wjohnsaunders/VoronMods/README.md

# VoronMods
Modified parts for my Voron Trident
