wjohnsaunders/VoronMods/Trident_InletSkirt_Ender3/README.md

# Trident Skirt Inlet for Ender3 style switch

This inlet fits switched and fused main inlets that is fitted to the
Ender3 and is common on many other 3D printers from China.

# Printing and Installed

Consult for Voron Trident manual, it is much the same as the stock one.
