wjohnsaunders/VoronMods/Trident_InletSkirt_SchurterDD12/README.md

# Schurter DD12 Inlet

This is a remix of the Schurter Inlet found on Voron Mods. That one was too
tight and didn't fit the DD12 model that I bought. I just increased the
size of the cutout by a millimitre or so.

## Printing

Print as-is, outer side up.
