wjohnsaunders/VoronMods/BedFanMount5020Blower/CAD/BedFanMount5020Blower.FCStd

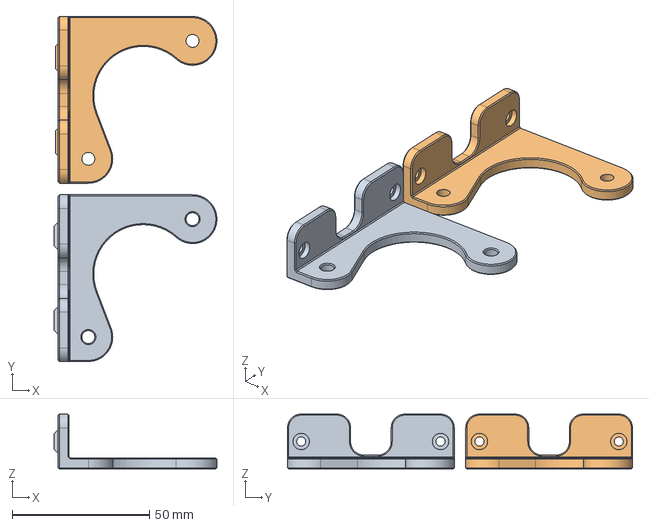
[picture p11: CAD file, 2026-07-20]
BedFanMount5020Blower/CAD/BedFanMount5020Blower.FCStd
59.4 x 125.8 x 20.0 mm
VSlot
Misumi
