wjohnsaunders/VoronMods/Fan_Hub_JST-XH/CAD/Fan_Hub_JST-XH.FCStd

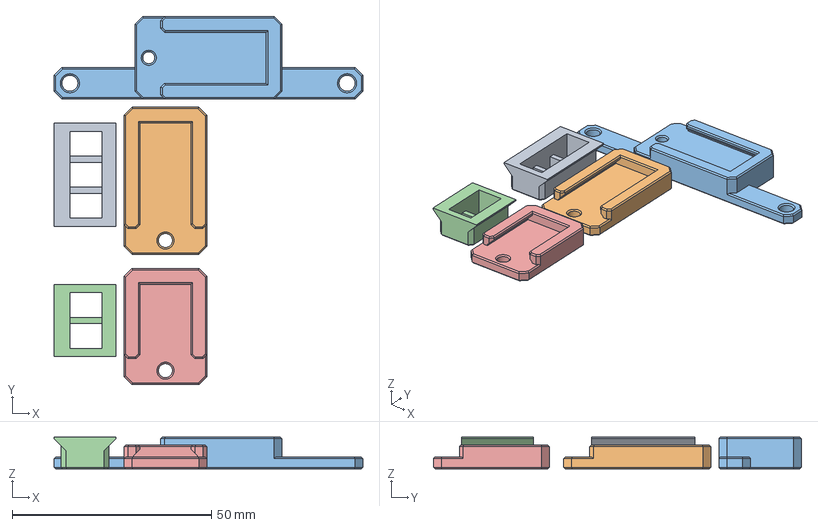
[picture p12: CAD file, 2026-07-20]
Fan_Hub_JST-XH/CAD/Fan_Hub_JST-XH.FCStd
77.6 x 92.5 x 8.00 mm
Holder-3way
BaseExtrusion-3way
BaseVoronFans-3way
Holder-2way
BaseExtrusion-2way
