wjohnsaunders/VoronMods/Fan_Hub_JST-XH/STL/Fan_Hub_JST-XH-BaseExtrusion-3way.stl

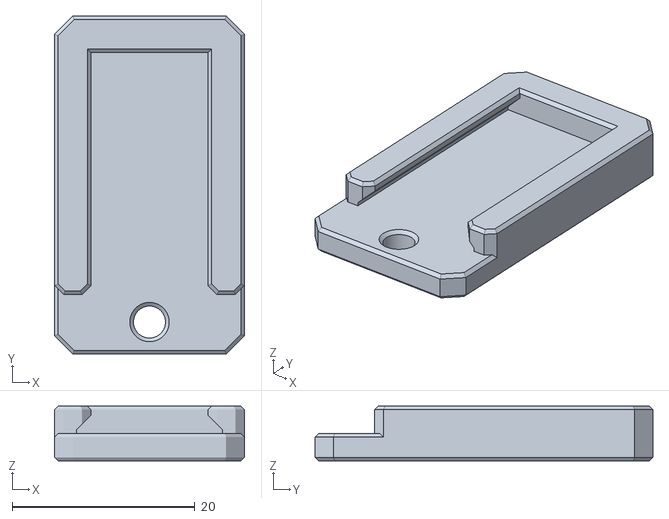
[picture p13: CAD file, 2026-07-20]
Fan_Hub_JST-XH/STL/Fan_Hub_JST-XH-BaseExtrusion-3way.stl
20.8 x 37.0 x 6.00
