wjohnsaunders/VoronMods/FumeExtraction/CAD/HoseAdapters-12.5mmHoseAdapter.step

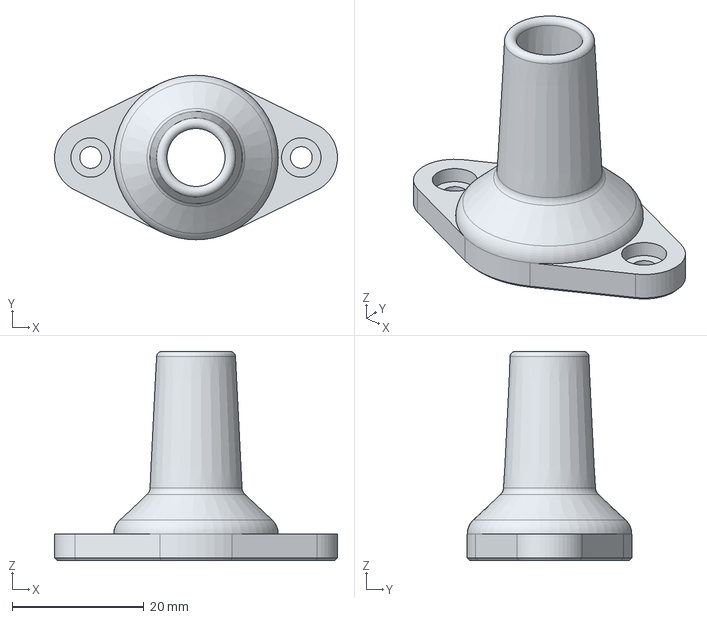
[picture p14: CAD file, 2026-07-13]
FumeExtraction/CAD/HoseAdapters-12.5mmHoseAdapter.step
43.0 x 25.0 x 31.8 mm
