wjohnsaunders/VoronMods/MGN12_Mods/MGN12_clickyclack_door/CAD/MGN12_Handle-Hinge_Top.FCStd

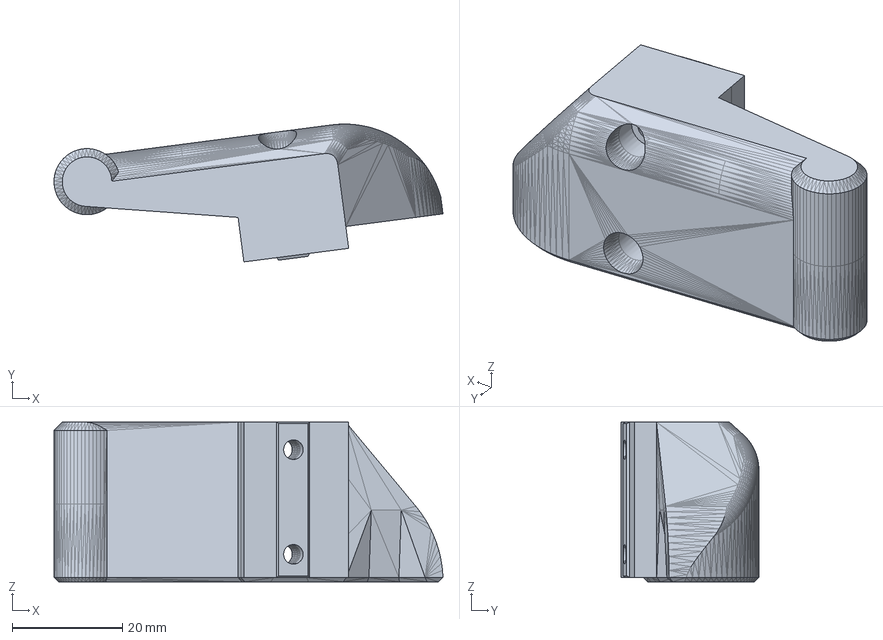
[picture p15: CAD file, 2026-07-13]
MGN12_Mods/MGN12_clickyclack_door/CAD/MGN12_Handle-Hinge_Top.FCStd
70.6 x 25.0 x 29.0 mm
