wjohnsaunders/VoronMods/MGN12_Mods/MGN12_y_endstop_housing/3MF/[a]_MGN12_y_endstop_housing.3mf

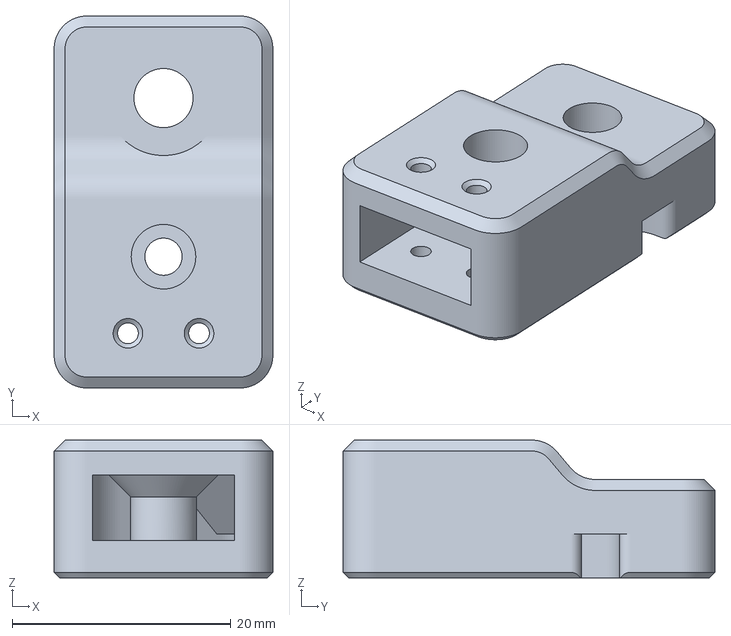
[picture p17: CAD file, 2025-08-18]
MGN12_Mods/MGN12_y_endstop_housing/3MF/[a]_MGN12_y_endstop_housing.3mf
20.0 x 34.0 x 12.6 mm
