wjohnsaunders/VoronMods/MGN12_Mods/MGN12_z_rail_stop/CAD/MGN12_z_rail_stop.FCStd

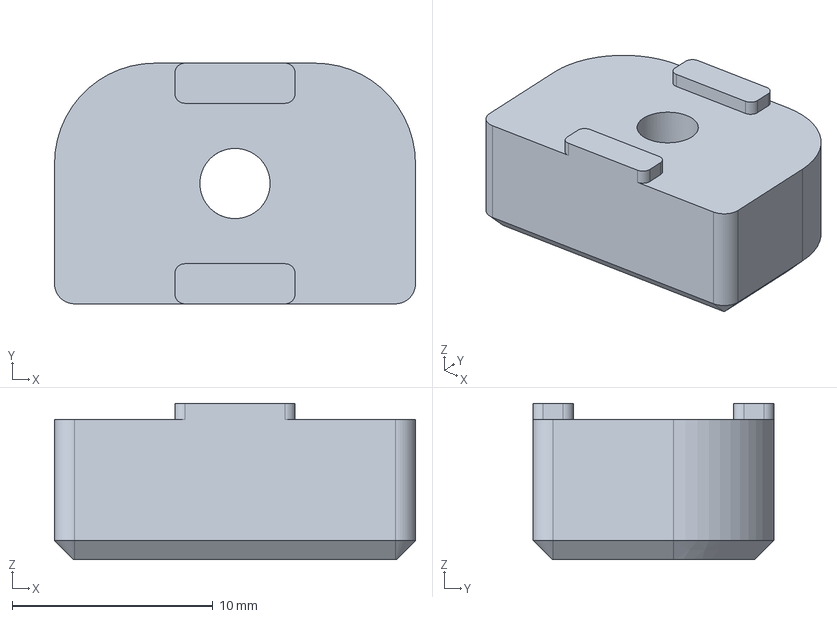
[picture p18: CAD file, 2025-08-18]
MGN12_Mods/MGN12_z_rail_stop/CAD/MGN12_z_rail_stop.FCStd
18.0 x 12.0 x 7.80 mm
