wjohnsaunders/VoronMods/Panel_Router_Templates/3MF/Deck_Panel_Router_Template-RearMotor.3mf

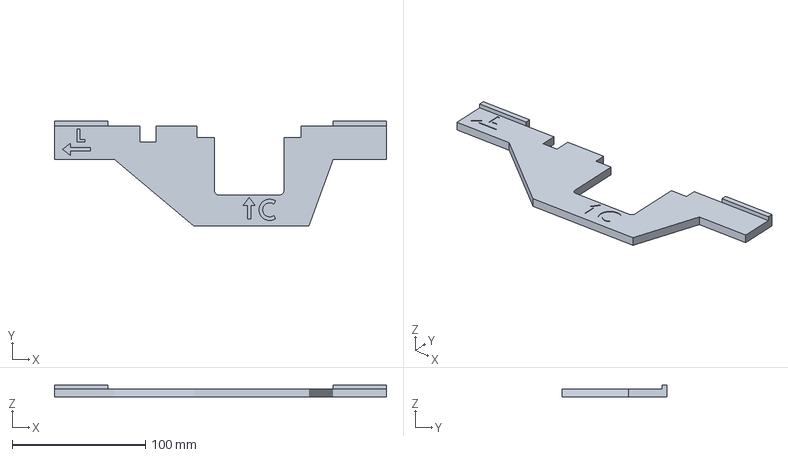
[picture p19: CAD file, 2025-08-18]
Panel_Router_Templates/3MF/Deck_Panel_Router_Template-RearMotor.3mf
249.0 x 79.0 x 9.00 mm
