wjohnsaunders/VoronMods/ThermistorExtrusionMount/CAD/ThermistorExtrusionMount.FCStd

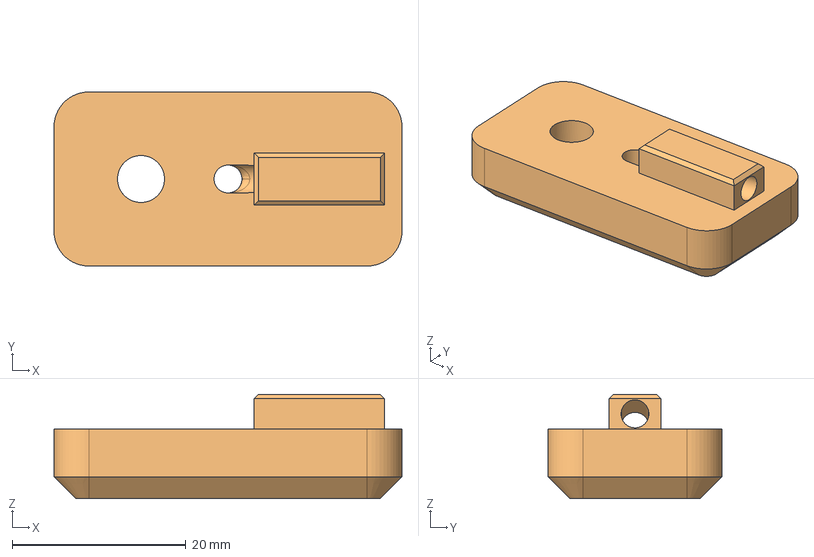
[picture p20: CAD file, 2026-07-13]
ThermistorExtrusionMount/CAD/ThermistorExtrusionMount.FCStd
40.0 x 20.0 x 12.0 mm
NoLogo
VoronLogoHorizontalMounted
VoronLogoVerticalMounted
