wjohnsaunders/VoronMods/Trident_InletSkirt_Ender3/CAD/TridentInletSkirt-Ender3.step

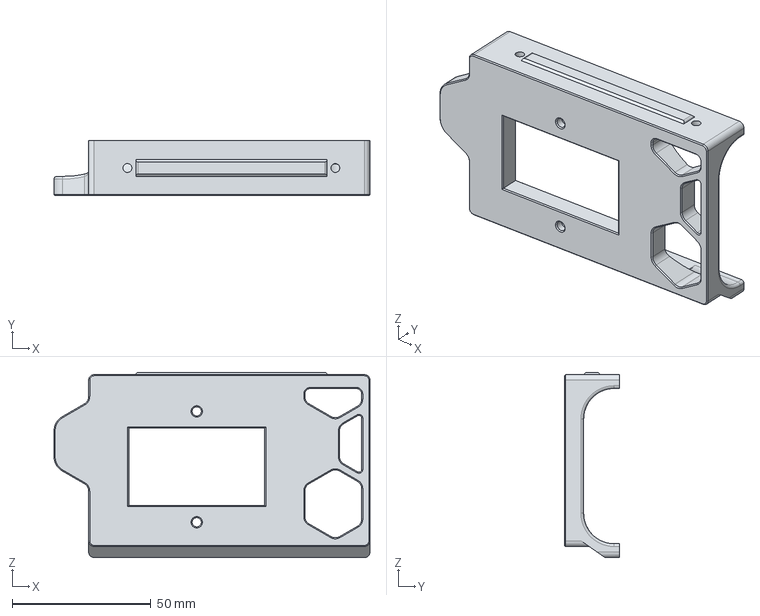
[picture p21: CAD file, 2026-07-13]
Trident_InletSkirt_Ender3/CAD/TridentInletSkirt-Ender3.step
114.0 x 20.0 x 66.8 mm
