wjohnsaunders/VoronMods/Trident_InletSkirt_SchurterDD12/CAD/Schurter_DD12_Inlet.FCStd

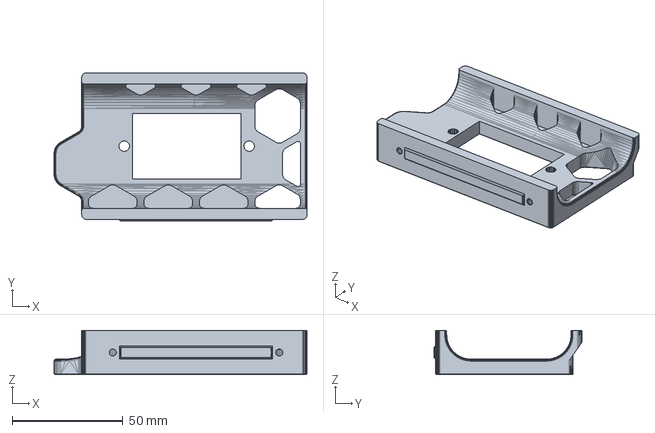
[picture p22: CAD file, 2025-08-18]
Trident_InletSkirt_SchurterDD12/CAD/Schurter_DD12_Inlet.FCStd
114.0 x 66.8 x 20.0 mm
