wjohnsaunders/VoronMods/Trident_R1_Mods/Coupler_z_stepper/CAD/z_stepper_small_rear.FCStd

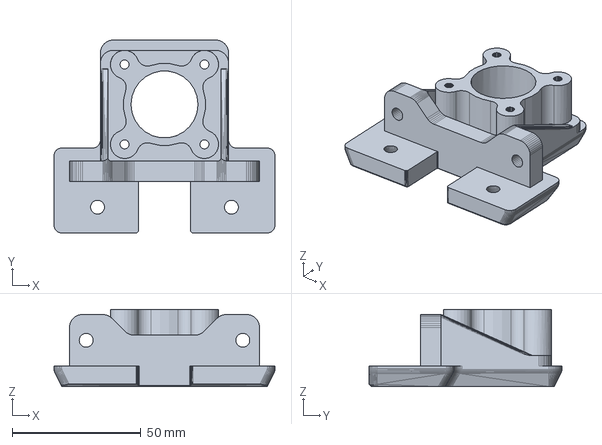
[picture p23: CAD file, 2025-10-06]
Trident_R1_Mods/Coupler_z_stepper/CAD/z_stepper_small_rear.FCStd
85.8 x 74.9 x 30.0 mm
