wjohnsaunders/VoronMods/Trident_R2_Mods/Coupler_z_stepper/CAD/R2_z_stepper.FCStd

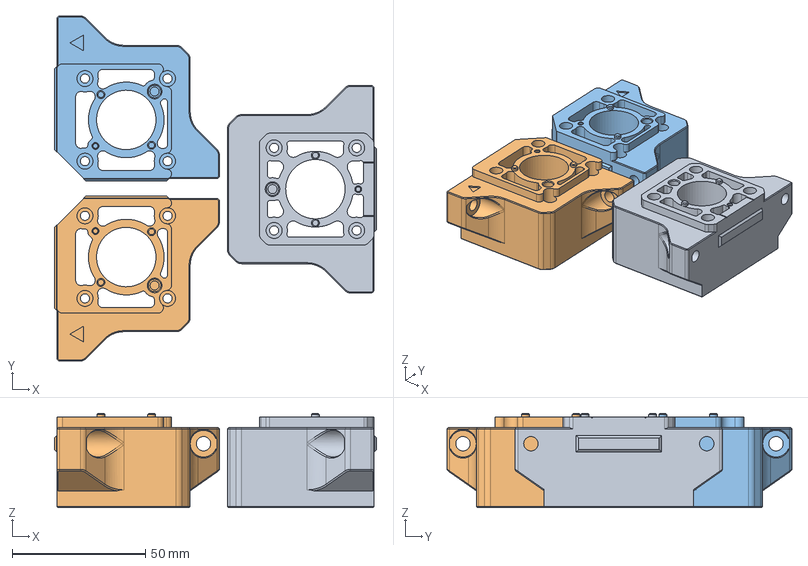
[picture p24: CAD file, 2026-07-13]
Trident_R2_Mods/Coupler_z_stepper/CAD/R2_z_stepper.FCStd
121.0 x 129.5 x 35.4 mm
rear_coupler
left_coupler
right_coupler
