wjohnsaunders/VoronMods/BedFanMount5020Blower/STL/BedFanMount5020Blower-VSlot.stl

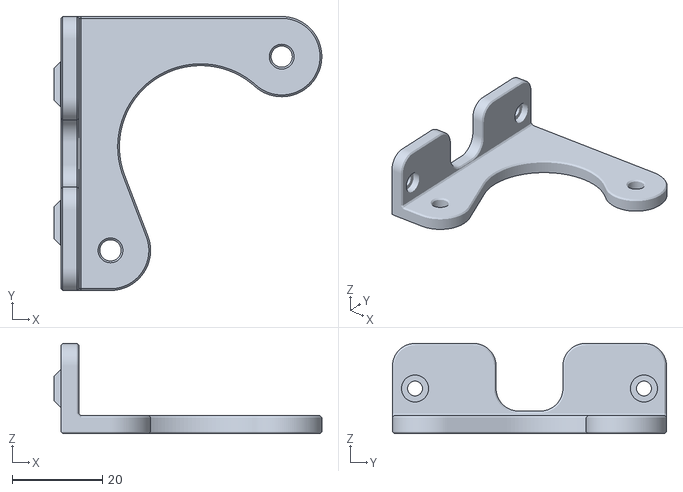
[picture p25: CAD file, 2026-07-20]
BedFanMount5020Blower/STL/BedFanMount5020Blower-VSlot.stl
59.4 x 60.8 x 20.0
