wjohnsaunders/VoronMods/Fan_Hub_JST-XH/STL/Fan_Hub_JST-XH-BaseExtrusion-2way.stl

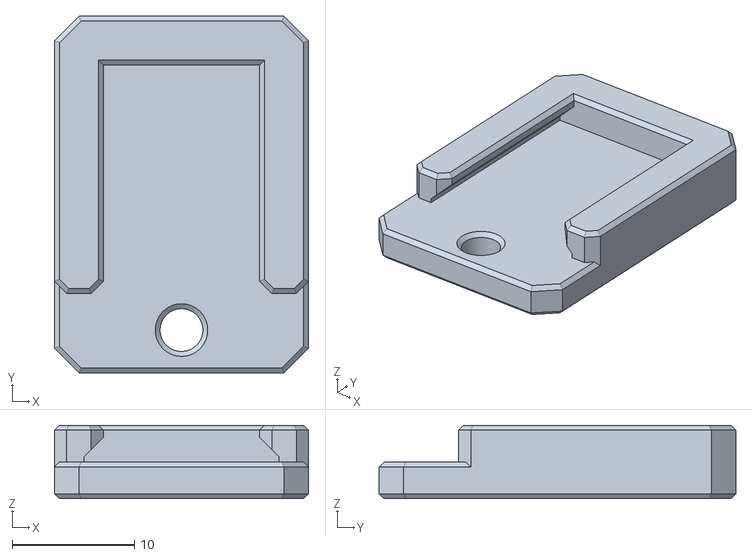
[picture p26: CAD file, 2026-07-20]
Fan_Hub_JST-XH/STL/Fan_Hub_JST-XH-BaseExtrusion-2way.stl
20.8 x 29.2 x 6.00
