wjohnsaunders/VoronMods/FumeExtraction/CAD/HoseAdapters-22mmISOTaperHoseAdapter.step

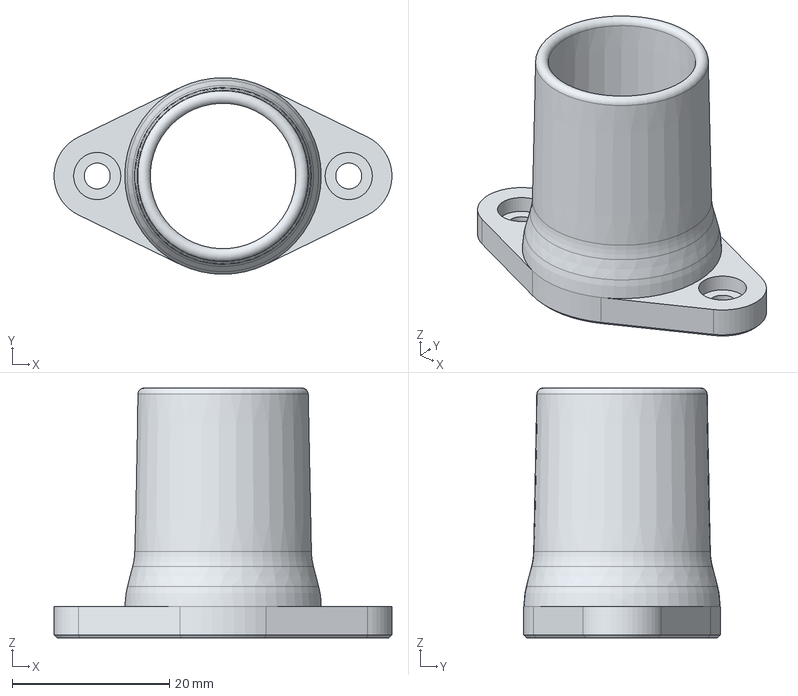
[picture p27: CAD file, 2026-07-13]
FumeExtraction/CAD/HoseAdapters-22mmISOTaperHoseAdapter.step
43.0 x 25.0 x 31.8 mm
