wjohnsaunders/VoronMods/MGN12_Mods/MGN12_clickyclack_door/CAD/MGN12_Handle-Hinge_Bottom.FCStd

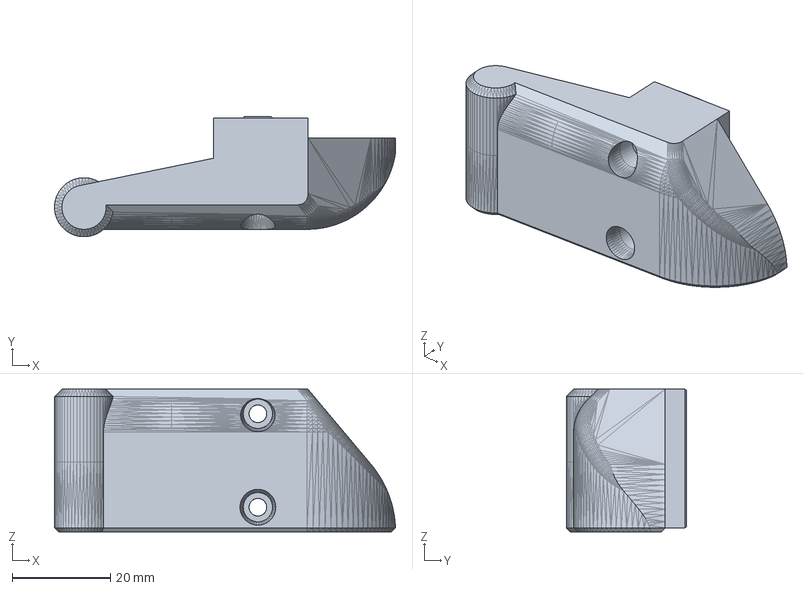
[picture p28: CAD file, 2025-08-18]
MGN12_Mods/MGN12_clickyclack_door/CAD/MGN12_Handle-Hinge_Bottom.FCStd
69.3 x 24.5 x 29.0 mm
