wjohnsaunders/VoronMods/MGN12_Mods/MGN12_panel_clips/CAD/corner_panel_clip_7p5mm.FCStd

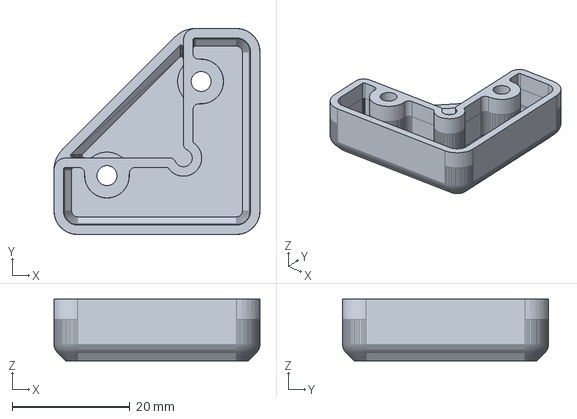
[picture p29: CAD file, 2026-07-13]
MGN12_Mods/MGN12_panel_clips/CAD/corner_panel_clip_7p5mm.FCStd
35.0 x 35.0 x 10.5 mm
