wjohnsaunders/VoronMods/Panel_Router_Templates/3MF/Deck_Panel_Router_Template-LeftRightMotor.3mf

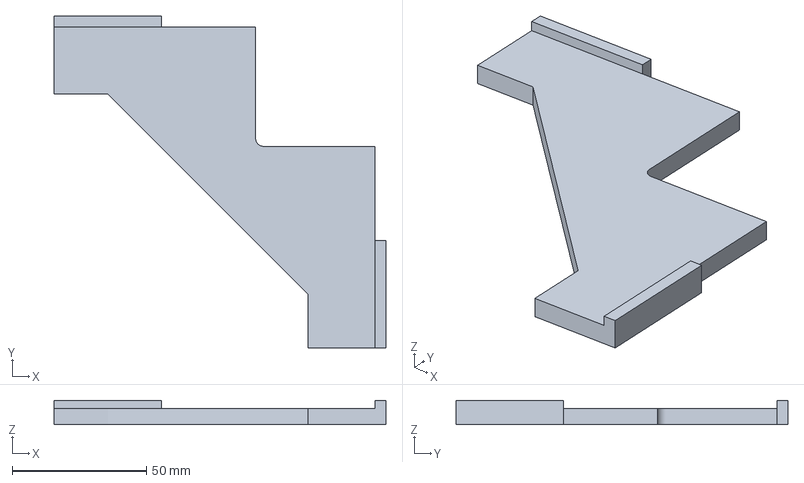
[picture p30: CAD file, 2025-08-18]
Panel_Router_Templates/3MF/Deck_Panel_Router_Template-LeftRightMotor.3mf
123.5 x 123.5 x 9.00 mm
