wjohnsaunders/VoronMods/Panel_Router_Templates/CAD/Rear_Panel_Router_Template.FCStd

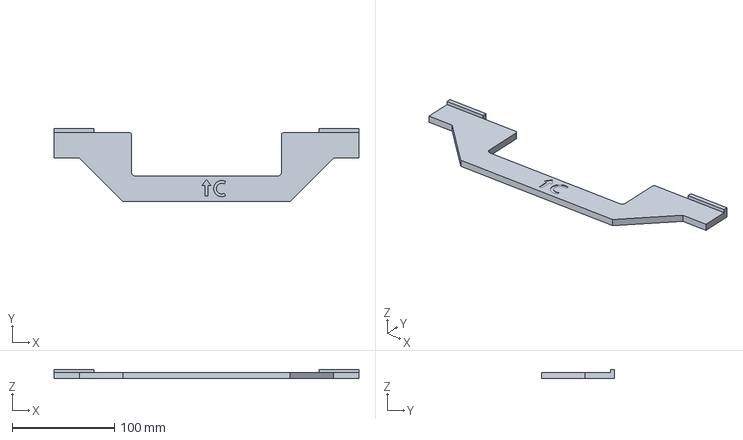
[picture p31: CAD file, 2025-08-18]
Panel_Router_Templates/CAD/Rear_Panel_Router_Template.FCStd
299.0 x 71.5 x 9.00 mm
