wjohnsaunders/VoronMods/ThermistorExtrusionMount/CAD/ThermistorExtrusionMount-VoronLogoHorizontalMounted.step

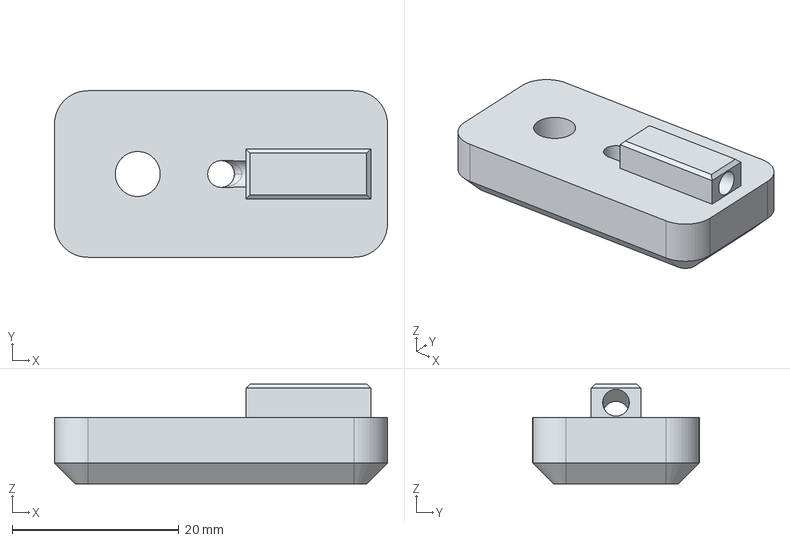
[picture p32: CAD file, 2026-07-13]
ThermistorExtrusionMount/CAD/ThermistorExtrusionMount-VoronLogoHorizontalMounted.step
40.0 x 20.0 x 12.0 mm
