wjohnsaunders/VoronMods/Trident_R1_Mods/Coupler_z_stepper/CAD/z_stepper_small_left.FCStd

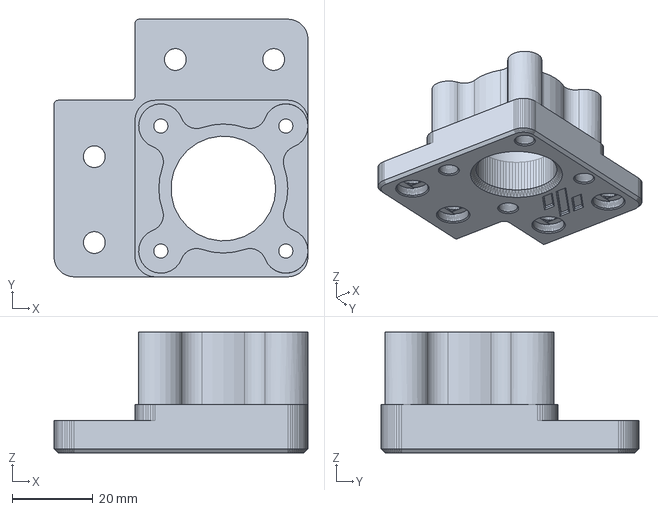
[picture p33: CAD file, 2025-10-06]
Trident_R1_Mods/Coupler_z_stepper/CAD/z_stepper_small_left.FCStd
63.0 x 63.9 x 30.0 mm
