wjohnsaunders/VoronMods/Trident_R2_Mods/Coupler_z_stepper/CAD/R2_z_stepper-rear_coupler.step

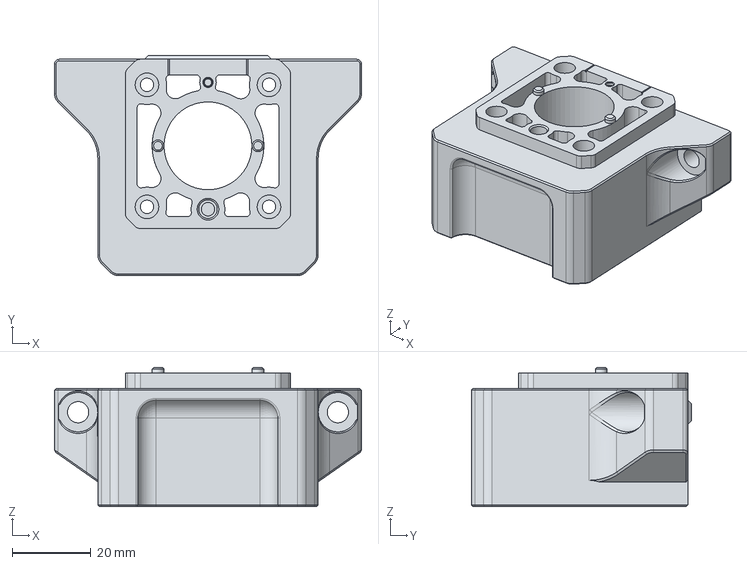
[picture p34: CAD file, 2026-07-13]
Trident_R2_Mods/Coupler_z_stepper/CAD/R2_z_stepper-rear_coupler.step
78.0 x 56.0 x 35.4 mm
