wjohnsaunders/VoronMods/Fan_Hub_JST-XH/STL/Fan_Hub_JST-XH-BaseVoronFans-3way.stl

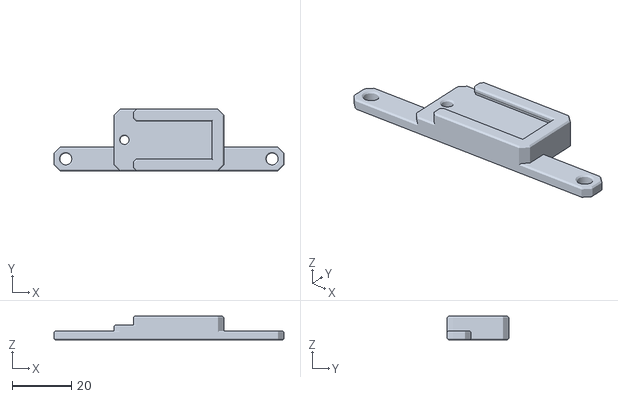
[picture p35: CAD file, 2026-07-20]
Fan_Hub_JST-XH/STL/Fan_Hub_JST-XH-BaseVoronFans-3way.stl
77.6 x 20.8 x 8.00
