wjohnsaunders/VoronMods/FumeExtraction/CAD/FumeExtraction.FCStd

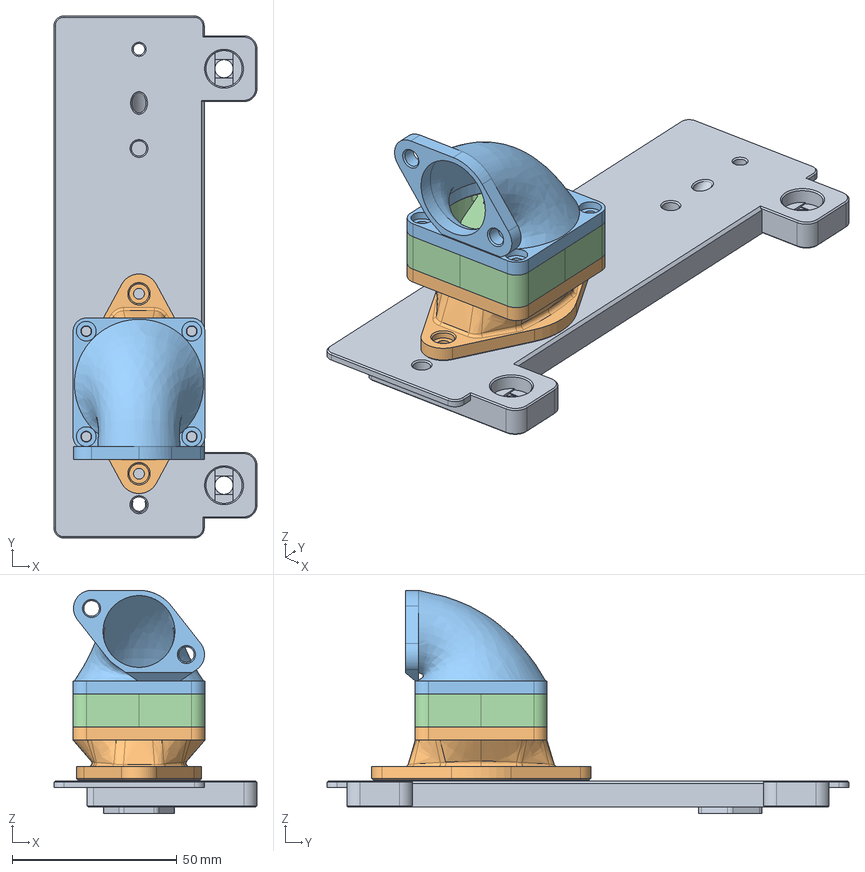
[picture p36: CAD file, 2026-07-13]
FumeExtraction/CAD/FumeExtraction.FCStd
61.6 x 158.4 x 67.8 mm
ExhaustCoverR2WithVent
ExhaustToFanAdapter
FanToHoseAdapter
40mm fan v2
40mm fan v001
