wjohnsaunders/VoronMods/MGN12_Mods/MGN12_clickyclack_door/CAD/MGN12_Latch.FCStd

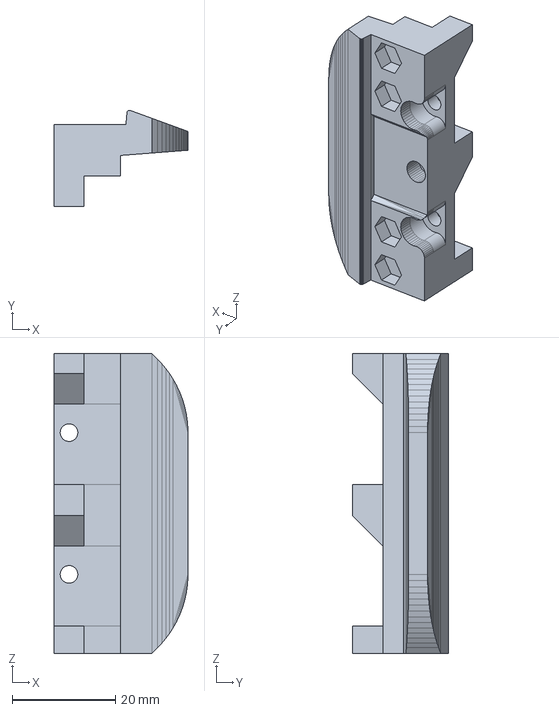
[picture p37: CAD file, 2025-08-18]
MGN12_Mods/MGN12_clickyclack_door/CAD/MGN12_Latch.FCStd
25.9 x 18.6 x 58.0 mm
