wjohnsaunders/VoronMods/MGN12_Mods/MGN12_panel_clips/CAD/midspan_panel_clip_7p5mm.FCStd

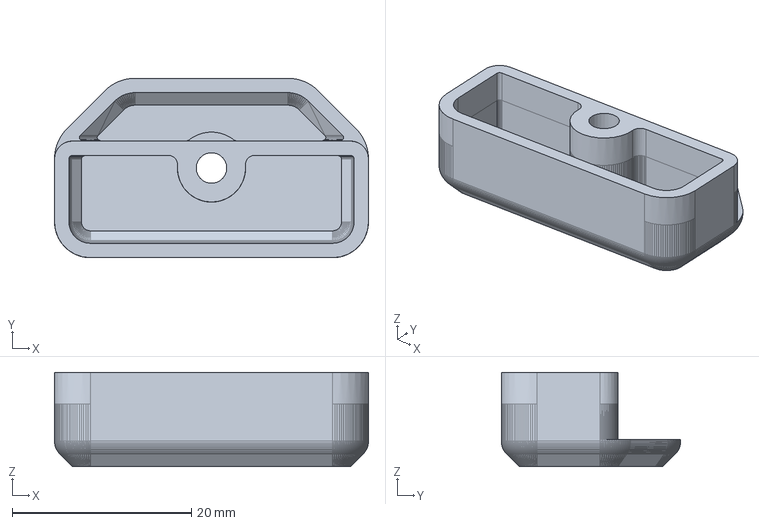
[picture p38: CAD file, 2026-07-13]
MGN12_Mods/MGN12_panel_clips/CAD/midspan_panel_clip_7p5mm.FCStd
35.0 x 20.0 x 10.5 mm
