wjohnsaunders/VoronMods/Panel_Router_Templates/3MF/Bottom_Panel_Router_Template-Corner.3mf

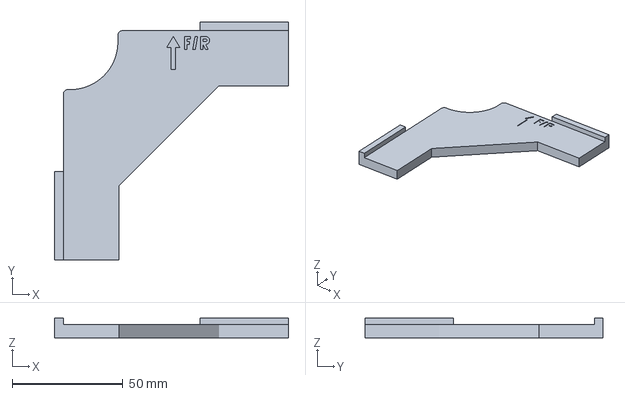
[picture p39: CAD file, 2025-08-18]
Panel_Router_Templates/3MF/Bottom_Panel_Router_Template-Corner.3mf
105.6 x 107.6 x 9.00 mm
