wjohnsaunders/VoronMods/Panel_Router_Templates/CAD/Bottom_Panel_Router_Template.FCStd

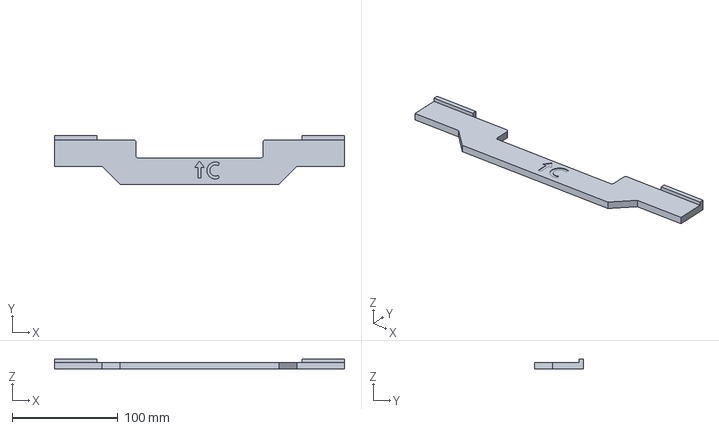
[picture p40: CAD file, 2025-08-18]
Panel_Router_Templates/CAD/Bottom_Panel_Router_Template.FCStd
274.0 x 46.0 x 9.00 mm
