wjohnsaunders/VoronMods/ThermistorExtrusionMount/CAD/ThermistorExtrusionMount-NoLogo.step

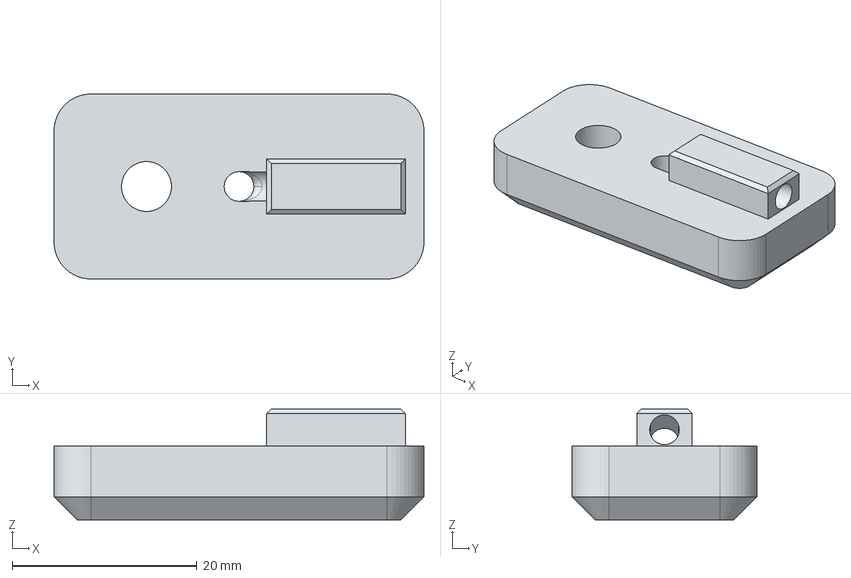
[picture p41: CAD file, 2026-07-13]
ThermistorExtrusionMount/CAD/ThermistorExtrusionMount-NoLogo.step
40.0 x 20.0 x 12.0 mm
