wjohnsaunders/VoronMods/Trident_R2_Mods/Coupler_z_stepper/CAD/R2_z_stepper-right_coupler.step

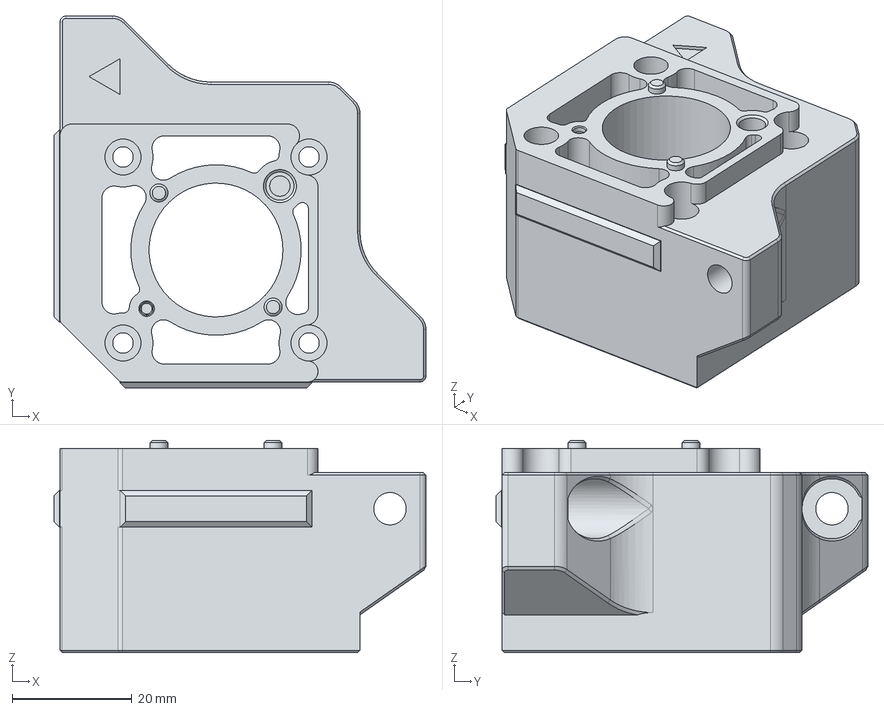
[picture p42: CAD file, 2026-07-13]
Trident_R2_Mods/Coupler_z_stepper/CAD/R2_z_stepper-right_coupler.step
62.0 x 62.0 x 35.4 mm
