wjohnsaunders/VoronMods/Fan_Hub_JST-XH/STL/Fan_Hub_JST-XH-Holder-3way.stl

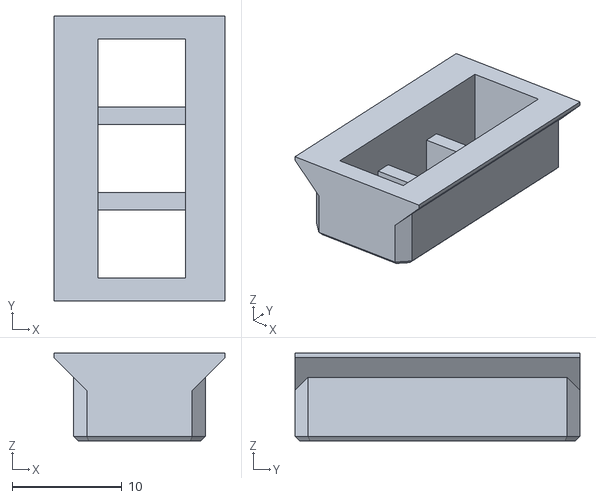
[picture p43: CAD file, 2026-07-20]
Fan_Hub_JST-XH/STL/Fan_Hub_JST-XH-Holder-3way.stl
15.6 x 26.0 x 8.00
