wjohnsaunders/VoronMods/FumeExtraction/CAD/HoseAdapters-25mmHoseAdapter.step

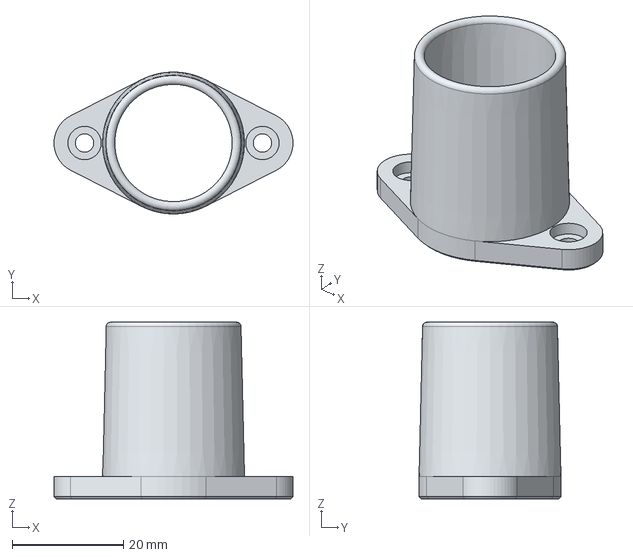
[picture p44: CAD file, 2026-07-13]
FumeExtraction/CAD/HoseAdapters-25mmHoseAdapter.step
43.0 x 25.6 x 31.8 mm
