wjohnsaunders/VoronMods/Fan_Hub_JST-XH/STL/Fan_Hub_JST-XH-Holder-2way.stl

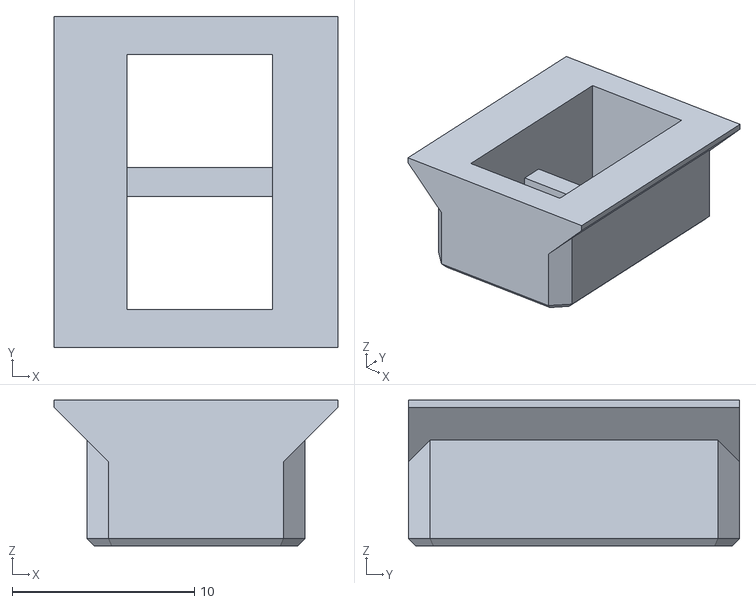
[picture p46: CAD file, 2026-07-20]
Fan_Hub_JST-XH/STL/Fan_Hub_JST-XH-Holder-2way.stl
15.6 x 18.2 x 8.00
