wjohnsaunders/VoronMods/FumeExtraction/CAD/FumeExtraction-ExhaustCoverR2WithVent.step

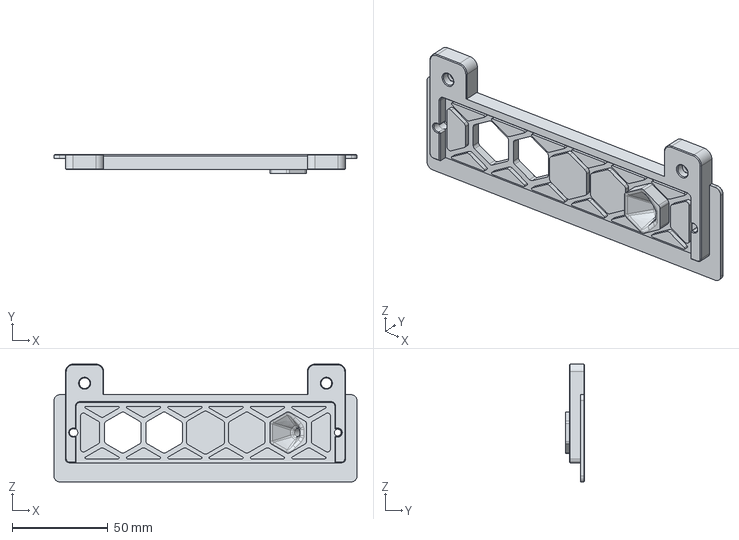
[picture p47: CAD file, 2026-07-13]
FumeExtraction/CAD/FumeExtraction-ExhaustCoverR2WithVent.step
158.4 x 10.0 x 61.6 mm
