wjohnsaunders/VoronMods/FumeExtraction/CAD/FumeExtraction-FanToHoseAdapter.step

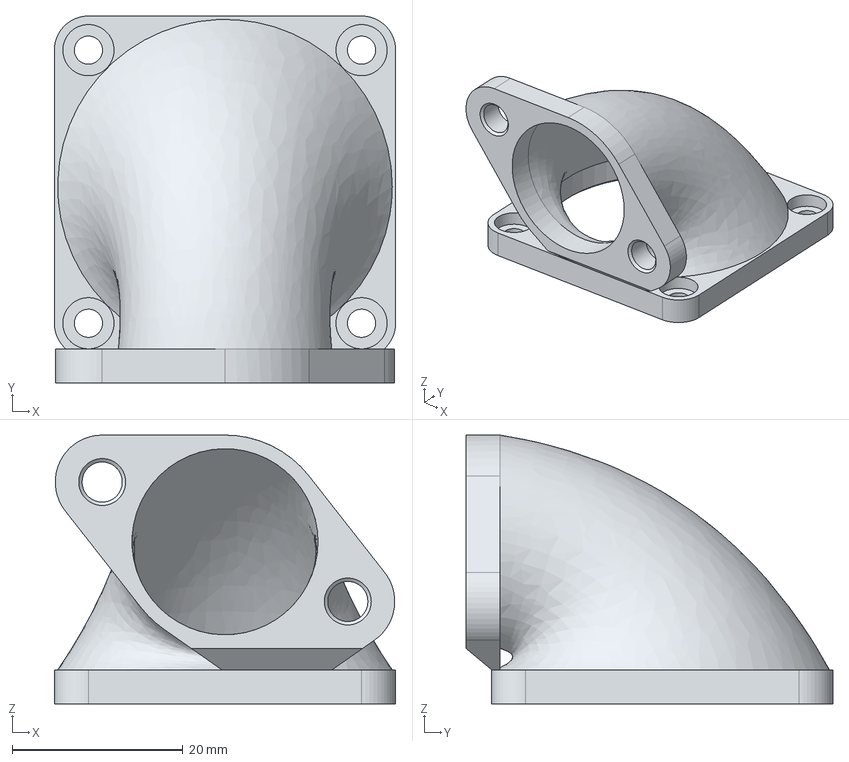
[picture p48: CAD file, 2026-07-13]
FumeExtraction/CAD/FumeExtraction-FanToHoseAdapter.step
40.0 x 43.0 x 31.5 mm
