wjohnsaunders/VoronMods/Panel_Router_Templates/3MF/Deck_Panel_Router_Template-CableCorner.3mf

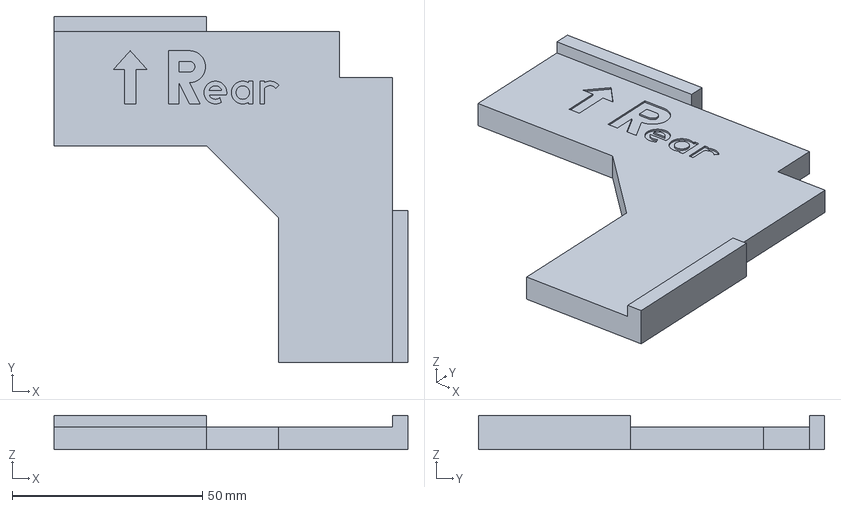
[picture p49: CAD file, 2025-08-18]
Panel_Router_Templates/3MF/Deck_Panel_Router_Template-CableCorner.3mf
93.0 x 91.0 x 9.00 mm
