wjohnsaunders/VoronMods/FumeExtraction/CAD/FumeExtraction-ExhaustToFanAdapter.step

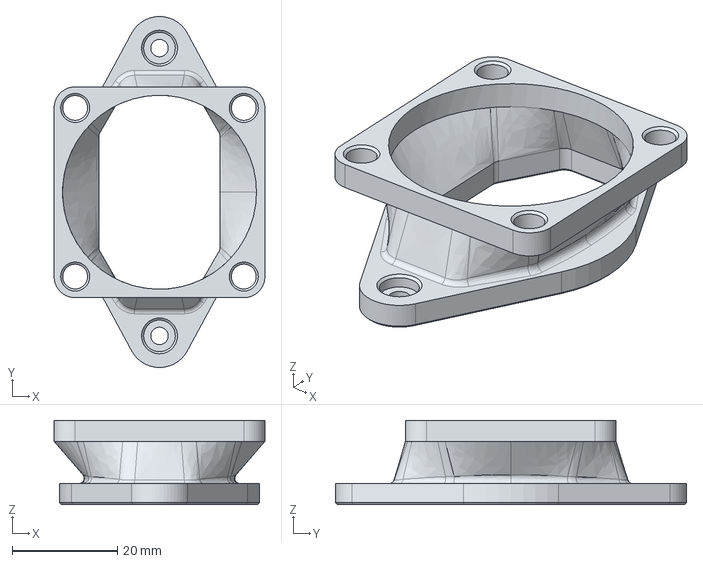
[picture p50: CAD file, 2026-07-13]
FumeExtraction/CAD/FumeExtraction-ExhaustToFanAdapter.step
40.0 x 66.6 x 16.0 mm
