wjohnsaunders/VoronMods/FumeExtraction/CAD/HoseAdapters.FCStd

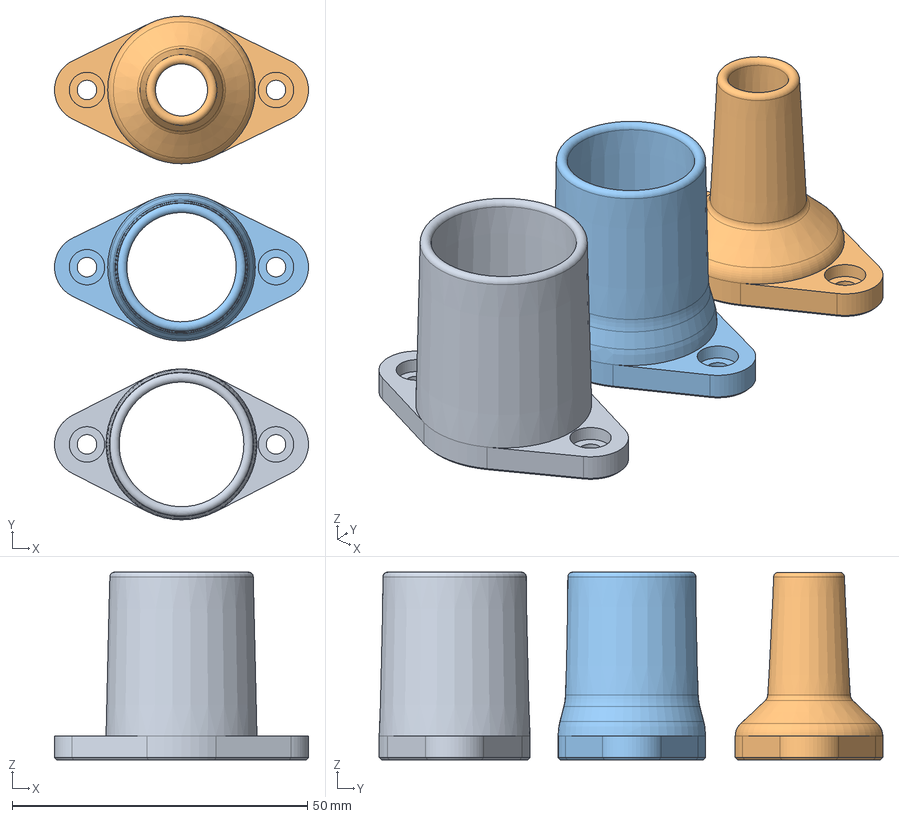
[picture p51: CAD file, 2026-07-13]
FumeExtraction/CAD/HoseAdapters.FCStd
43.0 x 85.3 x 31.8 mm
25mmHoseAdapter
12.5mmHoseAdapter
22mmISOTaperHoseAdapter
