wjohnsaunders/VoronMods/(list of files, cad)

Other CAD files:
MGN12_Mods/MGN12_y_endstop_housing/CAD/MGN12_y_endstop_housing.FCStd
Panel_Router_Templates/CAD/Deck_Panel_Router_Template.FCStd
Trident_InletSkirt_Ender3/CAD/TridentInletSkirt.FCStd
Trident_R1_Mods/Coupler_z_stepper/CAD/z_stepper_small_right.FCStd
Panel_Router_Templates/3MF/Rear_Panel_Router_Template-ExhaustExit.3mf
ThermistorExtrusionMount/CAD/ThermistorExtrusionMount-VoronLogoVerticalMounted.step
Trident_R2_Mods/Coupler_z_stepper/CAD/R2_z_stepper-left_coupler.step
Panel_Router_Templates/3MF/Bottom_Panel_Router_Template-Screen.3mf
BedFanMount5020Blower/STL/BedFanMount5020Blower-Misumi.stl
FumeExtraction/STL/FumeExtraction-ExhaustCoverR2WithVent.stl
FumeExtraction/STL/FumeExtraction-ExhaustToFanAdapter.stl
FumeExtraction/STL/FumeExtraction-FanToHoseAdapter.stl
FumeExtraction/STL/HoseAdapters-12.5mmHoseAdapter.stl
FumeExtraction/STL/HoseAdapters-22mmISOTaperHoseAdapter.stl
FumeExtraction/STL/HoseAdapters-25mmHoseAdapter.stl
MGN12_Mods/MGN12_clickyclack_door/3MF/MGN12_Handle-Hinge_Bottom.3mf
MGN12_Mods/MGN12_clickyclack_door/3MF/MGN12_Handle-Hinge_Top.3mf
MGN12_Mods/MGN12_clickyclack_door/3MF/MGN12_Latch.3mf
MGN12_Mods/MGN12_clickyclack_door/STL/MGN12_Handle-Hinge_Bottom.stl
MGN12_Mods/MGN12_clickyclack_door/STL/MGN12_Handle-Hinge_Top.stl
MGN12_Mods/MGN12_clickyclack_door/STL/MGN12_Latch.stl
MGN12_Mods/MGN12_panel_clips/3MF/corner_panel_clip_4p5mm.3mf
MGN12_Mods/MGN12_panel_clips/3MF/corner_panel_clip_7p5mm.3mf
MGN12_Mods/MGN12_panel_clips/3MF/midspan_panel_clip_4p5mm.3mf
MGN12_Mods/MGN12_panel_clips/3MF/midspan_panel_clip_7p5mm.3mf
MGN12_Mods/MGN12_panel_clips/STL/corner_panel_clip_4p5mm.stl
MGN12_Mods/MGN12_panel_clips/STL/corner_panel_clip_7p5mm.stl
MGN12_Mods/MGN12_panel_clips/STL/midspan_panel_clip_4p5mm.stl
MGN12_Mods/MGN12_panel_clips/STL/midspan_panel_clip_7p5mm.stl
MGN12_Mods/MGN12_y_endstop_housing/STL/MGN12_y_endstop_housing.stl
MGN12_Mods/MGN12_z_rail_stop/3MF/MGN12_z_rail_stop.3mf
MGN12_Mods/MGN12_z_rail_stop/STL/MGN12_z_rail_stop.stl
Panel_Router_Templates/STL/Bottom_Panel_Router_Template-Corner.stl
Panel_Router_Templates/STL/Bottom_Panel_Router_Template-Screen.stl
Panel_Router_Templates/STL/Deck_Panel_Router_Template-CableCorner.stl
Panel_Router_Templates/STL/Deck_Panel_Router_Template-LeftRightMotor.stl
Panel_Router_Templates/STL/Deck_Panel_Router_Template-RearMotor.stl
Panel_Router_Templates/STL/Rear_Panel_Router_Template-ExhaustExit.stl
ThermistorExtrusionMount/STL/ThermistorExtrusionMount-NoLogo.stl
ThermistorExtrusionMount/STL/ThermistorExtrusionMount-VoronLogoHorizontalMounted.stl
ThermistorExtrusionMount/STL/ThermistorExtrusionMount-VoronLogoVerticalMounted.stl
Trident_InletSkirt_Ender3/STL/TridentInletSkirt-Ender3.stl
Trident_InletSkirt_SchurterDD12/3MF/Schurter_DD12_Inlet.3mf
Trident_InletSkirt_SchurterDD12/STL/Schurter_DD12_Inlet.stl
Trident_R1_Mods/Coupler_z_stepper/STL/z_stepper_small_left.stl
Trident_R1_Mods/Coupler_z_stepper/STL/z_stepper_small_rear.stl
Trident_R1_Mods/Coupler_z_stepper/STL/z_stepper_small_right.stl
Trident_R2_Mods/Coupler_z_stepper/STL/R2_z_stepper-left_coupler.stl
Trident_R2_Mods/Coupler_z_stepper/STL/R2_z_stepper-rear_coupler.stl
Trident_R2_Mods/Coupler_z_stepper/STL/R2_z_stepper-right_coupler.stl
