wjohnsaunders/VoronMods/(commit log)

2025-08-18 Add CAD and STL for modification needed to build my Trident 300
    [Bottom_Panel_Router_Template-Corner.3mf, Bottom_Panel_Router_Template-Screen.3mf, Bottom_Panel_Router_Template.FCStd, Deck_Panel_Router_Template-CableCorner.3mf, Deck_Panel_Router_Template-LeftRightMotor.3mf, Deck_Panel_Router_Template-RearMotor.3mf, Deck_Panel_Router_Template.FCStd, MGN12_Handle-Hinge_Bottom.3mf]
2025-08-18 Add STL files and move 3MF files to another directory
    [Bottom_Panel_Router_Template-Corner.3mf, Bottom_Panel_Router_Template-Corner.stl, Bottom_Panel_Router_Template-Screen.3mf, Bottom_Panel_Router_Template-Screen.stl, Deck_Panel_Router_Template-CableCorner.3mf, Deck_Panel_Router_Template-CableCorner.stl, Deck_Panel_Router_Template-LeftRightMotor.3mf, Deck_Panel_Router_Template-LeftRightMotor.stl]
2025-09-15 Add fan hub for JST-XH connectors
    [Fan_Hub_JST-XH.FCStd, Fan_Hub_JST-XH_BaseExtrusion-3way.stl, Fan_Hub_JST-XH_BaseVoronFans-3way.stl, Fan_Hub_JST-XH_Holder-3way.stl]
2025-10-06 Redesigned to prevent hot chamber air from entering the electronics compartment
    [z_stepper_small_left.3mf, z_stepper_small_left.FCStd, z_stepper_small_left.stl, z_stepper_small_rear.3mf, z_stepper_small_rear.FCStd, z_stepper_small_rear.stl, z_stepper_small_right.3mf, z_stepper_small_right.FCStd]
2026-06-16 Add support for Trident R2 Z stepper mounts.
    [R2_z_stepper-left_coupler.stl, R2_z_stepper-rear_coupler.stl, R2_z_stepper-right_coupler.stl, R2_z_stepper.FCStd, z_stepper_small_left.FCStd, z_stepper_small_left.stl, z_stepper_small_rear.FCStd, z_stepper_small_rear.stl]
2026-06-17 Fixed failed pocket in the R2 left stepper mount.
    [R2_z_stepper-left_coupler.stl, R2_z_stepper.FCStd]
2026-06-29 Added an exhaust fan back to the Trident R2 rear exhaust panel
    [FumeExtraction-ExhaustCoverR2.stl, FumeExtraction-ExhaustToFanAdapter.stl, FumeExtraction-FanToHoseAdapter.stl, FumeExtraction.FCStd, HoseAdapters-19mmHoseAdapter.stl, HoseAdapters-22mmHoseAdapter.stl, HoseAdapters-25mmHoseAdapter.stl, HoseAdapters.FCStd]
2026-07-13 New thermistor mount for chamber temp
    [ThermistorExtrusionMount-NoLogo.step, ThermistorExtrusionMount-NoLogo.stl, ThermistorExtrusionMount-VoronLogoHorizontalMounted.step, ThermistorExtrusionMount-VoronLogoHorizontalMounted.stl, ThermistorExtrusionMount-VoronLogoVerticalMounted.step, ThermistorExtrusionMount-VoronLogoVerticalMounted.stl, ThermistorExtrusionMount.FCStd]
2026-07-13 Move all MGN12 mods under a single directory
    [MGN12_Handle-Hinge_Bottom.3mf, MGN12_Handle-Hinge_Bottom.FCStd, MGN12_Handle-Hinge_Bottom.stl, MGN12_Handle-Hinge_Top.3mf, MGN12_Handle-Hinge_Top.FCStd, MGN12_Handle-Hinge_Top.stl, MGN12_Latch.3mf, MGN12_Latch.FCStd]
2026-07-13 Added inlet skirt for Ender3. Rename Schurter directory.
    [Schurter_DD12_Inlet.3mf, Schurter_DD12_Inlet.FCStd, Schurter_DD12_Inlet.stl, TridentInletSkirt-Ender3.step, TridentInletSkirt-Ender3.stl, TridentInletSkirt.FCStd]
2026-07-13 Update FumeExtraction model after prototype issues.
    [FumeExtraction-ExhaustCoverR2WithVent.step, FumeExtraction-ExhaustCoverR2WithVent.stl, FumeExtraction-ExhaustToFanAdapter.step, FumeExtraction-ExhaustToFanAdapter.stl, FumeExtraction-FanToHoseAdapter.step, FumeExtraction-FanToHoseAdapter.stl, FumeExtraction.FCStd, HoseAdapters-12.5mmHoseAdapter.step]
2026-07-13 Design of the R2 Z stepper mounts to contain a coupler below the cover.
    [R2_z_stepper-left_coupler.step, R2_z_stepper-left_coupler.stl, R2_z_stepper-rear_coupler.step, R2_z_stepper-rear_coupler.stl, R2_z_stepper-right_coupler.step, R2_z_stepper-right_coupler.stl, R2_z_stepper.FCStd]
2026-07-20 Add be fan mount. Move folders around.
    [BedFanMount5020Blower-Misumi.stl, BedFanMount5020Blower-VSlot.stl, BedFanMount5020Blower.FCStd, R2_z_stepper-left_coupler.step, R2_z_stepper-left_coupler.stl, R2_z_stepper-rear_coupler.step, R2_z_stepper-rear_coupler.stl, R2_z_stepper-right_coupler.step]
2026-07-20 Update Fan Hub to include 2-way version.
    [Fan_Hub_JST-XH-BaseExtrusion-2way.stl, Fan_Hub_JST-XH-BaseExtrusion-3way.stl, Fan_Hub_JST-XH-BaseVoronFans-3way.stl, Fan_Hub_JST-XH-Holder-2way.stl, Fan_Hub_JST-XH-Holder-3way.stl, Fan_Hub_JST-XH.FCStd, Fan_Hub_JST-XH_BaseExtrusion-3way.stl, Fan_Hub_JST-XH_BaseVoronFans-3way.stl]
